ayuusweetfish/Drifting-Pulses/mech/rack.scad

unit_x = 21.8;
unit_y = 22.8;
n = 3;

unit_pitch = 100;
wire_slot = 8;
block_w = 5;
side_slot_ext = 30;

shell_thickness = 1;
shell_front_height = 30;
shell_front_drop = 6;
shell_back_height = 12;
block_height = 4;

punch_r = 3;
punch_y = 4;

full_x = (side_slot_ext + block_w) * 2 + unit_pitch * (n - 1) + unit_x;
full_y = unit_y;

module shell() union() {
  t = shell_thickness;
  // Bottom
  translate([-t, -t, -t])
    cube([full_x + t * 2, full_y + t * 2, t]);
  // Left, right
  translate([-t, -t, 0])
    cube([t, full_y + t * 2, shell_back_height]);
  translate([full_x, -t, 0])
    cube([t, full_y + t * 2, shell_back_height]);
  // Back
  translate([-t, full_y, 0])
    cube([full_x + t * 2, t, shell_back_height]);
  // Front
  translate([-t, -t, -shell_front_drop])
    cube([full_x + t * 2, t, shell_front_height]);
}

unit0_x = side_slot_ext + block_w;

module shell_punched() difference() {
  shell();
  for (i = [0:n - 1]) {
    translate([unit0_x + unit_x / 2 + unit_pitch * i, 0, punch_y])
    rotate(90, [1, 0, 0])
      cylinder(shell_thickness, punch_r, punch_r, $fn = 24);
  }
}

module full_model() union() {
  shell_punched();
  for (i = [0:n - 1]) {
    translate([unit0_x - block_w + unit_pitch * i, 0, 0])
      cube([block_w, full_y - wire_slot, block_height]);
    translate([unit0_x + unit_x + unit_pitch * i, 0, 0])
      cube([block_w, full_y - wire_slot, block_height]);
  }
}

intersection() {
  full_model();
  translate([-shell_thickness, 0.001, -shell_thickness])
    cube([full_x + shell_thickness * 2, full_y + shell_thickness, shell_back_height]);
}

translate([0, -5 - shell_front_height - shell_front_drop, 0])
  rotate(90, [1, 0, 0])
    intersection() {
      full_model();
      translate([-shell_thickness, -shell_thickness, -shell_front_drop])
        cube([full_x + shell_thickness * 2, shell_thickness, shell_front_height]);
    }
