ayuusweetfish/Drifting-Pulses/hw_rack/Pulse_Wind_Rack.kicad_pcb

## KiCad design hw_rack/Pulse_Wind_Rack.kicad_pcb (2025-08-13)

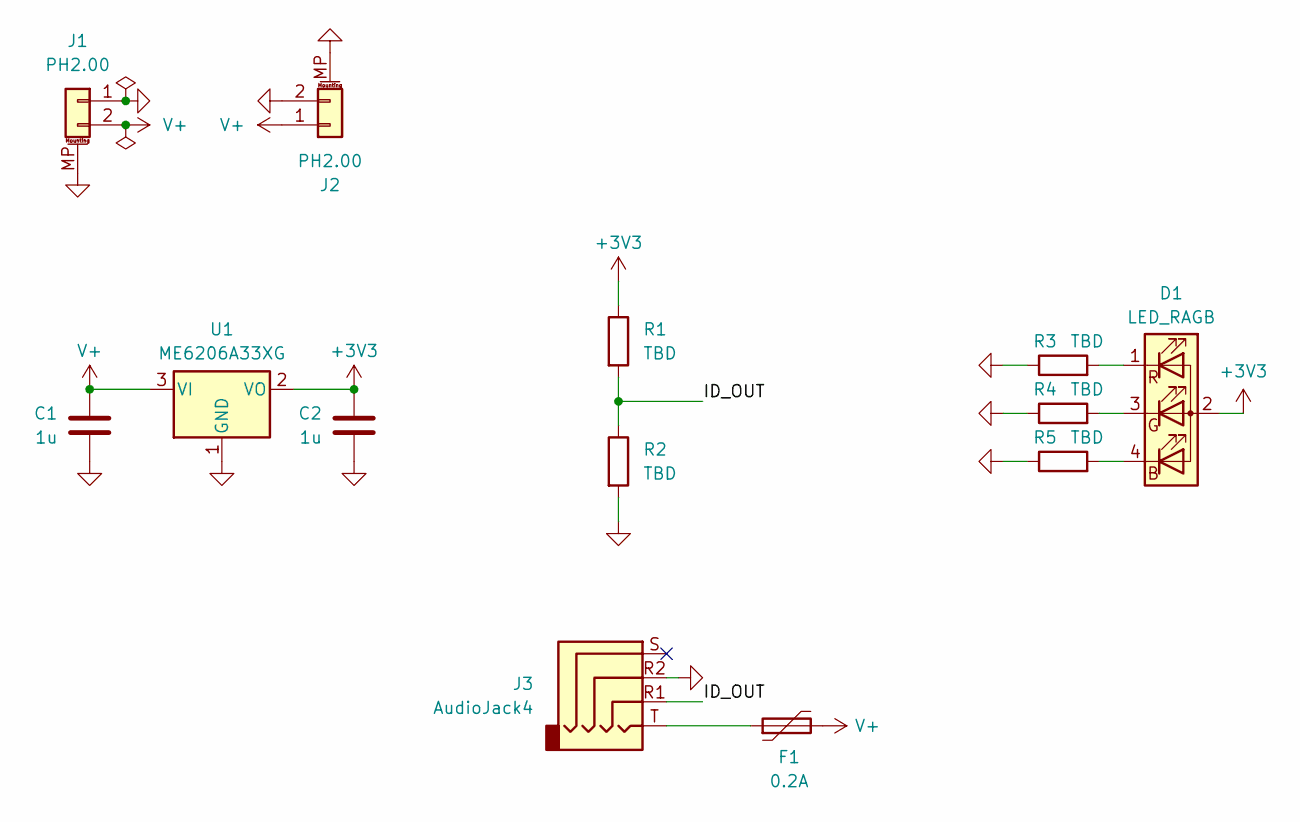
[picture p1: schematic Pulse_Wind_Rack.kicad_sch]

Parts:
C1, C2: 1u; C_0402_1005Metric
D1: LED_RAGB; LED_D5.0mm-4_RGB
F1: 0.2A; Fuse_0603_1608Metric
J1, J2: PH2.00; JST_PH_S2B-PH-SM4-TB_1x02-1MP_P2.00mm_Horizontal
J3: AudioJack4; Jack_3.5mm_KoreanHropartsElec_PJ-320D-4A_Horizontal
R1, R2, R3, R4, R5: TBD; R_0402_1005Metric
U1: ME6206A33XG; SOT-23

Connections:
+3V3: C2.2, D1.2 (A), R1.1, U1.2 (VO)
/ID_OUT: J3.R1, R1.2, R2.1
GND: C1.1, C2.1, J1.1, J1.MP (MountPin), J2.2, J2.MP (MountPin), J3.R2, R2.2, R3.1, R4.1, R5.1, U1.1 (GND)
unnamed: D1.4 (BK), R5.2
unnamed: D1.3 (GK), R4.2
unnamed: D1.1 (RK), R3.2
unnamed: F1.1, J3.T
V+: C1.2, F1.2, J1.2, J2.1, U1.3 (VI)

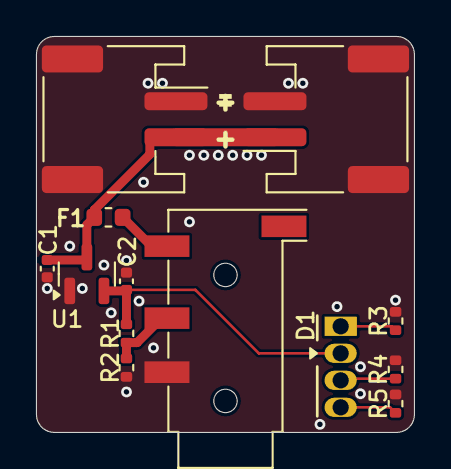
[picture p2: board Pulse_Wind_Rack.kicad_pcb from above]

Board: 2 copper layers, 21.0 x 22.0 mm, 13 parts (0 on the bottom side), 8 nets.
