ayuusweetfish/Drifting-Pulses/hw/Pulse_Wind.kicad_pcb

## KiCad design hw/Pulse_Wind.kicad_pcb (2025-08-06)

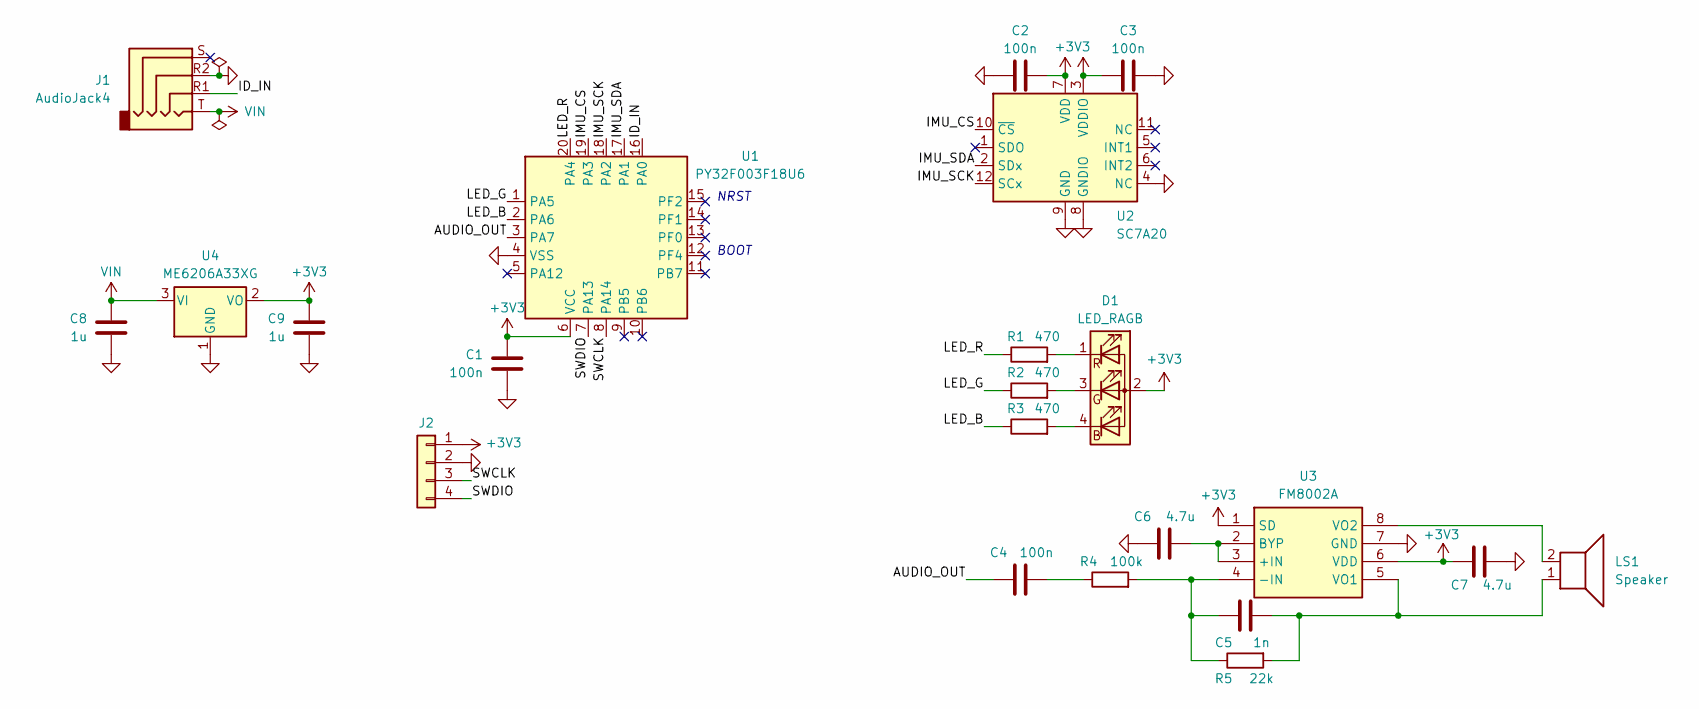
[picture p3: schematic Pulse_Wind.kicad_sch]

Parts:
C1, C2, C3, C4: 100n; C_0402_1005Metric
C5: 1n; C_0402_1005Metric
C6, C7: 4.7u; C_0402_1005Metric
C8, C9: 1u; C_0402_1005Metric
D1: LED_RAGB; LED_D5.0mm-4_RGB
J1: AudioJack4; Jack_3.5mm_KoreanHropartsElec_PJ-320D-4A_Horizontal
J2: Conn_01x04; TestPoints_1x04_P2.00
LS1: Speaker; Pads_P2.00
R1, R2, R3: 470; R_0402_1005Metric
R4: 100k; R_0402_1005Metric
R5: 22k; R_0402_1005Metric
U1: PY32F003F18U6; QFN-20-1EP_3x3mm_P0.4mm_EP1.65x1.65mm
U2: SC7A20; LGA-12_2x2mm_P0.5mm
U3: FM8002A; SOP-8_3.9x4.9mm_P1.27mm; Manufacturer_Part_Number MD8002A
U4: ME6206A33XG; SOT-23

Connections:
+3V3: C1.2, C2.2, C3.1, C7.1, C9.2, D1.2 (A), J2.1, U1.6 (VCC), U2.3 (VDDIO), U2.7 (VDD), U3.1 (SD), U3.6 (VDD), U4.2 (VO)
/AUDIO_OUT: C4.1, U1.3 (PA7)
/ID_IN: J1.R1, U1.16 (PA0)
/IMU_CS: U1.19 (PA3), U2.10 (~CS)
/IMU_SCK: U1.18 (PA2), U2.12 (SCx)
/IMU_SDA: U1.17 (PA1), U2.2 (SDx)
/LED_B: R3.1, U1.2 (PA6)
/LED_G: R2.1, U1.1 (PA5)
/LED_R: R1.1, U1.20 (PA4)
/SWCLK: J2.3, U1.8 (PA14)
/SWDIO: J2.4, U1.7 (PA13)
GND: C1.1, C2.1, C3.2, C6.1, C7.2, C8.1, C9.1, J1.R2, J2.2, U1.4 (VSS), U1.21 (PAD), U2.4 (NC), U2.8 (GNDIO), U2.9 (GND), U3.7 (GND), U4.1 (GND)
unnamed: C4.2, R4.1
unnamed: D1.4 (BK), R3.2
unnamed: D1.3 (GK), R2.2
unnamed: D1.1 (RK), R1.2
unnamed: C6.2, U3.2 (BYP), U3.3 (+IN)
unnamed: C5.1, R4.2, R5.1, U3.4 (-IN)
unnamed: C5.2, LS1.1, R5.2, U3.5 (VO1)
unnamed: LS1.2, U3.8 (VO2)
VIN: C8.2, J1.T, U4.3 (VI)

Notes on the sheet:
NRST
BOOT

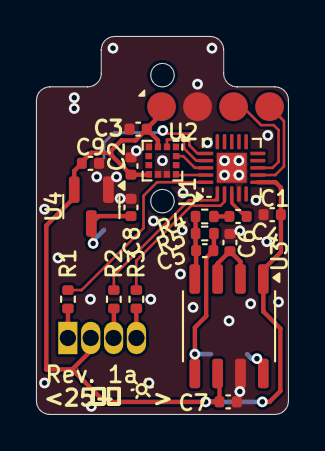
[picture p4: board Pulse_Wind.kicad_pcb from above]

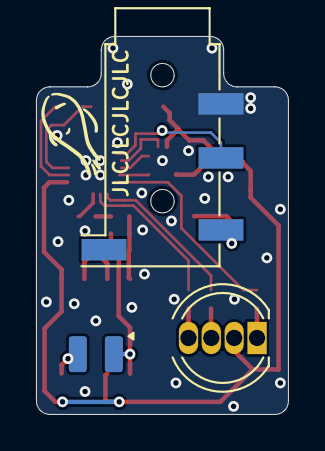
[picture p5: board Pulse_Wind.kicad_pcb from below]

Board: 2 copper layers, 14.0 x 21.0 mm, 22 parts (3 on the bottom side), 21 nets.
