ayuusweetfish/Drifting-Pulses/(commit log)

2025-08-05 hw: Bob-part schematic
    [Pulse_Wind.kicad_pcb, Pulse_Wind.kicad_sch]
2025-08-05 hw: Layout & routing
    [Pulse_Wind.kicad_pcb, Pulse_Wind.kicad_sch]
2025-08-05 hw: Tweaks in the details
    [Pulse_Wind.kicad_pcb]
2025-08-05 hw: Adjust silkscreen
    [Pulse_Wind.kicad_pcb, Pulse_Wind.kicad_sch]
2025-08-05 hw: Finalize board design
    [Pulse_Wind.kicad_pcb]
2025-08-06 hw: Fix errors (> <)
    [Pulse_Wind.kicad_pcb, Pulse_Wind.kicad_sch]
2025-08-06 hw: Connect SC7A20 NC (pin 4) to GND?
    [Pulse_Wind.kicad_pcb, Pulse_Wind.kicad_sch]
2025-08-06 hw: Minor tweaks; finalize
    [Pulse_Wind.kicad_pcb]
2025-08-06 hw: Rack schematic
    [Pulse_Wind_Rack.kicad_pcb, Pulse_Wind_Rack.kicad_sch]
2025-08-06 fw: Rack board? To be revised
    [Pulse_Wind_Rack.kicad_pcb, Pulse_Wind_Rack.kicad_sch]
2025-08-06 fw: Revise rack board layout & routing
    [Pulse_Wind_Rack.kicad_pcb]
2025-08-06 hw: Finalize rack board design
    [Pulse_Wind_Rack.kicad_pcb]
2025-08-09 mech: Add rack 3D model
    [rack.scad]
2025-08-09 mech: Save block material
    [rack.scad]
2025-08-09 mech: Split shell's front side into separate part
    [rack.scad]
2025-08-09 mech: Adjust parameters; test print
    [rack.scad]
2025-08-11 fw: Initial framework (based on Meteorites-Bianqing)
2025-08-11 fw: Read WHO_AM_I register from IMU
    WHO_AM_I = 0x34?
2025-08-11 fw: Correctly reading WHO_AM_I
    [main.c]
2025-08-11 fw: Correctly read from IMU's FIFO
    [main.c]
2025-08-11 fw: Fade LED
2025-08-11 fw: Run audio PWM with DMA
2025-08-11 fw: Correct clock frequency (8 MHz -> 24 MHz)
    [main.c]
2025-08-12 fw: Read ADC
    Reading VCC/2 results in 1950~1960
2025-08-13 hw: Add polyfuse in rack board
    [Pulse_Wind_Rack.kicad_pcb, Pulse_Wind_Rack.kicad_sch]
2025-08-17 fw: Blink LED with pendulum
    Not apparent enough
2025-08-17 hw: Comment schematic with actual components used
    [Pulse_Wind.kicad_sch]
